yashaswiim/machineLab_finalProject/Assets/README.md

## Link to Assets

Links to the stl files for 3D printing (Slider Mechanism)

Connecting Rod 
[v1](https://drive.google.com/file/d/13bx2AFQBkW5Mj_QZogoVsFYyxZ1VkfZP/view?usp=sharing)
[v2](https://drive.google.com/file/d/1-bRH7StdOu1GLQ_QhESZayj91Mdzfe3g/view?usp=sharing)
[v3](https://drive.google.com/file/d/11hN-DYs-KaBlS_36ypGBngZcgytpXnUJ/view?usp=sharing)

Base 
[v1](https://drive.google.com/file/d/18FmFoLwoQYJARwS0YUmkMX5Ynj6GiOIz/view?usp=sharing)
[v2](https://drive.google.com/file/d/1q4qjwrZdUslo3oK4vNqpXd27bdo068-e/view?usp=sharing)

Crank 
[v1](https://drive.google.com/file/d/1NimW1tdXTv9_-IkQB_BTkUsI5A9mMKzB/view?usp=sharing)
[v2](https://drive.google.com/file/d/1O_TzMNeDscBHZYQMWl4fjZkWYiF5oAQr/view?usp=sharing)
[v3](https://drive.google.com/file/d/1mln4DXzE4ZsGdYzDw8tlQM_FbhfwFLPx/view?usp=sharing)

Slider Mechanism 
[v1](https://drive.google.com/file/d/1SCAIMeT9X3_Pk1p736YGaqOeUYXEU4AY/view?usp=sharing)
[v2](https://drive.google.com/file/d/1Y9yvQDpMPWi1jKwd13V1dqw1Tcp_aF5e/view?usp=sharing)
[v3](https://drive.google.com/file/d/1DxZqGc1Tu4ZQhSMG4mAm_YcFJdAxPHIa/view?usp=share_link)

Slider 
[v1](https://drive.google.com/file/d/1YNvmU1gFPExyR7pfyBol2Z7WOtIpD-BV/view?usp=sharing)
[v2](https://drive.google.com/file/d/1YKNKcFK7uJ5mNhkixpMgeLapNUBVKHhj/view?usp=sharing)
[v3](https://drive.google.com/file/d/1PPGKZ_NR100J6dpC8ZpYiyg5-hKs-mIK/view?usp=sharing)

Links to the files for laser cutting 

TO DO
