yashaswiim/machineLab_finalProject/Schedule.md

| Task 									| Sub-tasks 										| Complete By 					|
|---									|---										|---					|
| Build slider mechanism for the prey | <li> Build the prototype with the 3D printed parts :heavy_check_mark: </li> | 2023 Apr 22
|										| <li> Finalize size / fix errors based on prototypes :heavy_check_mark: </li>|
|										| <li> Finalize material and build the final version :heavy_check_mark: </li>	|
|										| <li> Arduino code </li>									|
| 									| 										| 					|
| Build the flapping bird mechanism | <li> Laser cut the bird	</li>						| 2023 Apr 22
|										| <li> Re-prototype following the YouTube video <br /> (focus on precision and center of gravity)</li>		|
|										| <li> Attach motor and test mechanism </li>				|
|										| <li> Arduino code </li>									|
| 									| 										| 					|
| Build the mechanism for diving bird	| <li> Figure out the best way to make the bird <br /> (laser cut?) and build it	</li>		| 2023 Apr 22
|										| <li> Test the big servo motor to move the bird <br /> (in an arc (90 degrees))	</li>	|
|										| <li> Arduino code </li>									|
| 									| 										| 					|
| Build pulley mechanism for backdrop	| <li> Prepare the backdrop	</li>					| 2023 Apr 26
|										| <li> Extend the height of the shaft	:heavy_check_mark: </li>			|
|										| <li> Test the built mechanisms :heavy_check_mark: </li>				|
|										| <li> Arduino code </li>									|
| 									| 										| 					|
| Build the curtain mechanism			| <li> Build the basic wooden flap curtain mechanism </li>| 2023 Apr 26
|										| <li> Attach the motors and test with motors </li> |
|										| <li> Arduino code </li>									|
| 									| 										| 					|
| Build the hopping prey mechanism		| <li> Build the cam mechanism for the hopping preys </li>| 2023 Apr 26
|										| <li> Laser cut preys and attach them to the cam	</li>|
|										| <li> Arduino code </li>									|
| 									| 										| 					|
| Integration							| <li> Finalize motor speeds for the mechanisms to <br /> get the desired overall effect	</li>	| 2023 May 3
|										| <li> Figure out the wiring and positions of all <br /> mechanisms 		</li>		|
|										| <li> Combine and complete the codes 	</li>			|
|										| <li> Final touches									|
