yashaswiim/machineLab_finalProject/Assets/Links.md

Links to the stl files for 3D peinting (Slider Mechanism)

[Connecting Rod](https://drive.google.com/file/d/13bx2AFQBkW5Mj_QZogoVsFYyxZ1VkfZP/view?usp=sharing)

[Base](https://drive.google.com/file/d/18FmFoLwoQYJARwS0YUmkMX5Ynj6GiOIz/view?usp=sharing)

[Crank](https://drive.google.com/file/d/1NimW1tdXTv9_-IkQB_BTkUsI5A9mMKzB/view?usp=sharing)

[Slider Mechanism](https://drive.google.com/file/d/1SCAIMeT9X3_Pk1p736YGaqOeUYXEU4AY/view?usp=sharing)

[Slider](https://drive.google.com/file/d/1YNvmU1gFPExyR7pfyBol2Z7WOtIpD-BV/view?usp=sharing)
