yashaswiim/machineLab_finalProject/signal_test_code.ino

void setup() {
  // put your setup code here, to run once:
  Serial.begin(9600);

}

void loop() {
  // put your main code here, to run repeatedly:
  if(digitalRead(6)==1){
    Serial.println("A");
  }


}
