yashaswiim/machineLab_finalProject/(commit log)

2023-04-10 Slider prototype images
2023-04-19 add 3d printed slider image
