yashaswiim/machineLab_finalProject/Assets/Images/slider-mechanism-1.jpg

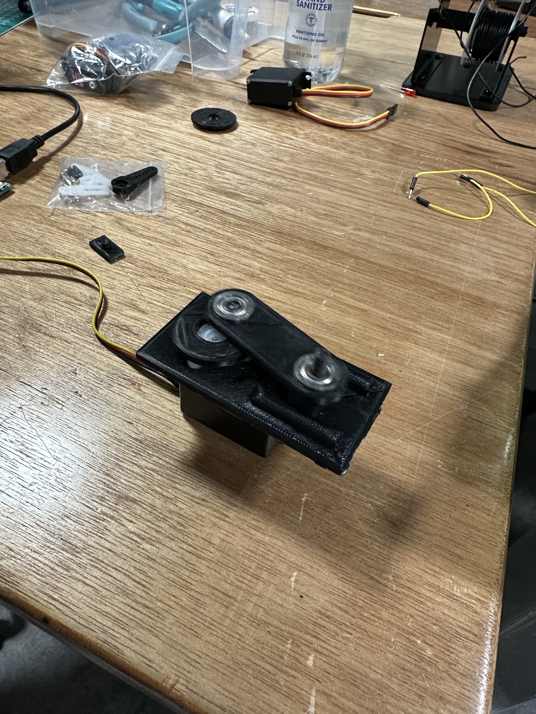
[picture p16: Assets/Images/slider-mechanism-1.jpg]
Assets/Images/slider-mechanism-1.jpg
